LTU-CEG/mav_power_protection/(commit log)

2018-09-22 Changed output cap, reduced size, fixed resistor value
    [mav_ovp-B.Paste.gbr, mav_ovp-F.Paste.gbr, mav_ovp.GBL, mav_ovp.GBO, mav_ovp.GBS, mav_ovp.GKO, mav_ovp.GTL, mav_ovp.GTO]
2018-11-03 Updated kicad_libs and README, changed specs for the output capacitor
    [mav_ovp.kicad_pcb, mav_ovp.sch]
2019-03-24 Now with castelated vias
    [mav_ovp-B.Paste.gbr, mav_ovp-B_Cu.gbr, mav_ovp-B_Mask.gbr, mav_ovp-B_Paste.gbr, mav_ovp-B_SilkS.gbr, mav_ovp-Edge_Cuts.gbr, mav_ovp-F_Cu.gbr, mav_ovp-F_Mask.gbr]
2019-03-25 Minor fixes
    [mav_ovp-B_Cu.gbr, mav_ovp-B_Mask.gbr, mav_ovp-B_Paste.gbr, mav_ovp-B_SilkS.gbr, mav_ovp-Edge_Cuts.gbr, mav_ovp-F_Cu.gbr, mav_ovp-F_Mask.gbr, mav_ovp-F_Paste.gbr]
